ChrisEilbeck/XiaoLogger/OLEDDisplay.h

#pragma once

#include <Adafruit_GFX.h>
#include <Adafruit_SSD1306.h>

#define SCREEN_WIDTH 128 // OLED display width, in pixels
#define SCREEN_HEIGHT 32 // OLED display height, in pixels
#define OLED_RESET     -1 // Reset pin # (or -1 if sharing Arduino reset pin)
#define SCREEN_ADDRESS 0x3C ///< See datasheet for Address; 0x3D for 128x64, 0x3C for 128x32

extern Adafruit_SSD1306 display;

void SetupOLEDDisplay(void);
void PollOLEDDisplay(uint32_t now);
