ChrisEilbeck/XiaoLogger/(commit log)

2022-04-19 This is for the actual board I've wired on
2022-04-19 This works with an old esp32 and a level shifter
2022-04-21 GPS, pressure sensor and accelerometer all working in this version.
2022-05-07 This is working. Long press time is probably a bit too long but it worked well logging various bits going up to and around Cumbria. Hardware now has a battery and a charger, and an on/off switch inte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
    [SDCard.h, SDCard.ino, XiaoLogger.ino]
2022-06-10 This is logging accel and pressure slowly, slowly, catchy monkey, and GPS data so it's good to try a flight on.
2022-06-20 Lots of refactoring. Currently setup for development. Don't use for real
2022-06-21 Now using the triggered reading of the pressure sensor from the GPS message. Also setting the system time from the GPS if the config file says to.
2023-03-16 Modified for the new microcontroller board I'm now using
2023-03-16 In a hacky way, this changes the baud rate on the Gps to 115.2K and has an interrupt tied into the 1PPS line. I'm intending on using this to synchronise the internal clock to GPS. As is, this measure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
    [Gps.ino, XiaoLogger.ino]
